swthemathwiz/wyse-5070-ethernet-adapter/wyse-commell-adapter.scad

//
// Copyright (c) Stewart H. Whitman, 2021.
//
// File:    wyse-commell-adapter.scad
// Project: Dell Wyse 5070 2nd Ethernet Adapter Adapter
// License: CC BY-NC-SA 4.0 (Attribution-NonCommercial-ShareAlike)
// Desc:    Adapter that holds Commell NIC Daughter-board
//

use <commell-nic.scad>
include <wyse-ethernet.scad>
