swthemathwiz/wyse-5070-ethernet-adapter/wyse-filler.scad

//
// Copyright (c) Stewart H. Whitman, 2020-2021.
//
// File:    wyse-filler.scad
// Project: Dell Wyse 5070 2nd Ethernet Adapter Adapter
// License: CC BY-NC-SA 4.0 (Attribution-NonCommercial-ShareAlike)
// Desc:    Blank to fill an uncovered slot
//

use <wyse-blank.scad>

// Filler
Wyse_Filler($fn=64);
