swthemathwiz/wyse-5070-ethernet-adapter/wyse-youyeetoo-adapter.scad

//
// Copyright (c) Stewart H. Whitman, 2024.
//
// File:    wyse-youyeetoo-adapter.scad
// Project: Dell Wyse 5070 2nd Ethernet Adapter Adapter
// License: CC BY-NC-SA 4.0 (Attribution-NonCommercial-ShareAlike)
// Desc:    Adapter that holds Youyeetoo (IIO-ALAN4 M.2 A+E Key 2230) NIC Daughter-board
//

use <youyeetoo-nic.scad>
include <wyse-ethernet.scad>
