swthemathwiz/wyse-5070-ethernet-adapter/(list of files, cad)

Other CAD files:
realtek-nic.scad
wyse-iocrest-adapter.scad
wyse-realtek-adapter.scad
wyse-winyao-adapter.scad
