swthemathwiz/wyse-5070-ethernet-adapter/(commit log)

2020-10-07 Initial release.
    [commell-nic.scad, hash.scad, primitives.scad, realtek-nic.scad, smidge.scad, wyse-blank.scad, wyse-ethernet.scad, wyse-filler.scad]
2020-10-07 Use list generator primitives instead of recursion.
    [hash.scad]
2020-10-07 Clean up terminology.
    [wyse-ethernet.scad]
2020-10-07 Comment changes.
    [commell-nic.scad]
2020-10-07 Add more description.
    [hash.scad]
2020-10-08 Use search() for lookup.
    [hash.scad]
2020-10-08 Remove redundant asserts. Decrease ear hole size to 3.6mm.
    [wyse-blank.scad]
2020-10-19 Clean up white space.
    [commell-nic.scad, hash.scad, wyse-blank.scad, wyse-ethernet.scad]
2021-11-23 Change from 0.001 to 0.01 (openscad change).
    [smidge.scad]
2021-11-23 Bump copyright.
    [hash.scad, primitives.scad, wyse-filler.scad]
2021-11-23 Create a hole list instead of separate holes. Add shield settings.
    [commell-nic.scad, realtek-nic.scad]
2021-11-23 Add winyao/DFrobot NIC.
    [winyao-nic.scad]
2021-11-23 Separate adapter builds due to new winyao/DFrobot NIC addition.
    [wyse-commell-adapter.scad, wyse-realtek-adapter.scad, wyse-winyao-adapter.scad]
2021-11-23 Change smidge (openscad change). Delete old nub code. Add experimental indent for shield work.
    [wyse-blank.scad]
2021-11-23 Add winyao/DFRobot NIC. Delete old mount height and nub code. Holes changed to list. Experimental shield stuff. Multiple troughs. Baffle height differences.
    [wyse-ethernet.scad]
2021-11-24 Whitespace changes.
    [wyse-ethernet.scad]
2021-12-07 Comment corrections, add US distributor information.
    [winyao-nic.scad]
2021-12-18 Fix non-inline STL links
2023-06-20 Rename realtek references to iocrest to avoid confusion.
    [iocrest-nic.scad, wyse-ethernet.scad, wyse-iocrest-adapter.scad]
2024-11-05 Add shield z-offset function.
    [commell-nic.scad, iocrest-nic.scad, winyao-nic.scad]
2024-11-05 Add handle size option. Limit cage slant depth.
    [wyse-blank.scad]
2024-11-05 Add Youyeetoo intel nic.
    [wyse-ethernet.scad, wyse-youyeetoo-adapter.scad, youyeetoo-nic.scad]
